kbeckmann/Glasgow/hardware/boards/glasgow/glasgow.kicad_pcb

## KiCad design hardware/boards/glasgow/glasgow.kicad_pcb (2018-10-31)

Schematic: glasgow.sch, Base Board

Parts:
C1, C14, C16, C19, C26, C27, C28, C76, C80: 4u7; C_0603_1608Metric_Pad1.05x0.95mm_HandSolder; MPN LMK107BJ475KAHT
C2, C3, C4, C5, C6, C7, C8, C9, C10, C13, C15, C17, C18, C20, C21, C22, C23, C24, C25, C33, C77, C81: u1; C_0402_1005Metric; MPN TMK107BJ154KA-T
C11, C12: 18p; C_0402_1005Metric; MPN CC0603JRNPO8BN180
C78, C79: u1; C_0402_1005Metric; MPN LMK107BJ475KAHT
D1, D2, D3: GRN; LED_0603_1608Metric_Pad0.82x1.00mm_HandSolder; MPN 150060GS75000
D4: YEL; LED_0603_1608Metric_Pad0.82x1.00mm_HandSolder; MPN 150060YS75000
D5: RED; LED_0603_1608Metric_Pad0.82x1.00mm_HandSolder; MPN 150060RS75000
J1: USB_B_Micro; USB_Micro-B_Molex_47346-0001; MPN 47346-0001
J4: Conn_01x02; PinHeader_1x02_P2.54mm_Horizontal; MPN 22-05-3021
J5: Conn_02x22_Odd_Even; PinHeader_2x22_P1.27mm_Vertical_SMD
MK1, MK2, MK3, MK4: Mounting_Hole_PAD; MountingHole_3.2mm_M3_Pad
MK5, MK6: Mounting_Hole; MountingHole_2.5mm
R1, R2, R12, R13, R14: 2k2; R_0402_1005Metric; MPN RC0603FR-132K2L
R3: 1M; R_0402_1005Metric; MPN RC0603FR-131ML
R4, R6, R7, R8, R9, R17, R18, R19: 100k; R_0402_1005Metric; MPN RC0603FR-10100KL
R5: 220k; R_0402_1005Metric; MPN RC0603FR-10220KL
R10: 130; R_0402_1005Metric; MPN AC0603FR-07130RL
R15: 390; R_0402_1005Metric; MPN RC0603FR-13390RL
R16: 604; R_0402_1005Metric; MPN RC0603FR-07604RL
R31, R32: 100; R_0402_1005Metric; MPN RC0603FR-07100RL
TP1: 5V; TestPoint_Pad_D1.0mm
TP2: 1V2; TestPoint_Pad_D1.0mm
TP3, TP7: 3V3; TestPoint_Pad_D1.0mm
TP4: SDA; TestPoint_Pad_D1.0mm
TP5: SCL; TestPoint_Pad_D1.0mm
TP6: CLKREF; TestPoint_Pad_D1.0mm
U1: CY7C68013A-56LTX; Cypress_QFN-56-1EP_8x8mm_P0.5mm_EP6.22x6.22mm_ThermalVias; MPN CY7C68013A-56LTXC
U2: CAT24M01W; SOIC-8_3.9x4.9mm_P1.27mm; MPN CAT24M01WI-GT3
U3: CAT24C256W; SOIC-8_3.9x4.9mm_P1.27mm; MPN CAT24C256WI-GT3
U7: LM3880MF-1AF; SOT-23-6; MPN LM3880MFX-1AF/NOPB
U8: MIC5355-S4YMME; MSOP-8-1EP_3x3mm_P0.65mm_EP2.54x2.8mm_ThermalVias; MPN MIC5355-S4YMME
U15: TPD3S014; SOT-23-6; MPN TPD3S014DBVR
U30: ICE40HX8K-BG121; BGA-121_9.0x9.0mm_Layout11x11_P0.8mm_Ball0.4mm_Pad0.35mm_NS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
Y1: 24M; Crystal_SMD_3225-4pin_3.2x2.5mm; MPN LFXTAL058124REEL

Connections:
+1V2: C18.1, C24.1, C25.1, C27.1, C77.1, J5.6, R31.2, R32.2, TP2.1, U8.7, U30.D4, U30.D8, U30.H4, U30.H8
+3V3: C1.1, C2.1, C3.1, C4.1, C5.1, C6.1, C7.1, C9.1, C10.1, C14.1, C15.1, C16.1, C17.1, C19.1, C20.1, C21.1, C22.1, C23.1, C28.1, C81.1, J5.4, R1.2, R2.2, R4.2, R10.2, R12.1, R17.2, TP3.1, U1.3, U1.7, U1.11, U1.17, U1.27, U1.32, U1.43, U1.44, U1.55, U2.2, U2.8, U3.1 (A0), U3.8 (VCC), U8.8, U30.C10, U30.D6, U30.F8, U30.H6, U30.L11; also elsewhere on the board
+5V: C26.1, J5.2, R5.2, R7.2, R8.2, TP1.1, U7.1, U8.1, U15.4; also elsewhere on the board
/1V2EN: R8.1, U7.6, U8.4
/3V3EN: R7.1, U7.5, U8.5
/A0: U1.37, U30.K3
/A1: U1.38, U30.L2
/CLKIF: TP7.1, U1.13, U30.K6
/CLKREF: TP6.1, U1.54, U30.L5
/D0: U1.18, U30.H7
/D1: U1.19, U30.J7
/D2: U1.20, U30.J9
/D3: U1.21, U30.K10
/D4: U1.22, U30.L10
/D5: U1.23, U30.K9
/D6: U1.24, U30.L8
/D7: U1.25, U30.K7
/ENVA: R18.1, U1.45; also elsewhere on the board
/ENVB: R19.1, U1.51; also elsewhere on the board
/FLAGA: U1.29, U30.L7
/FLAGB: U1.30, U30.K5
/FLAGC: U1.31, U30.L4
/FLAGD: U1.40, U30.J3
/FPGA_DONE: U1.36, U30.K8
/GNDPLL0: C76.2, C78.2, U30.L6
/GNDPLL1: C79.2, C80.2, U30.C5
/LED_ACT: R15.1, U1.49
/LED_CY: R13.1, U1.47
/LED_ERR: R16.1, U1.50
/LED_FPGA: R14.1, U1.48
/OE: U1.35, U30.L3
/PGOOD: R5.1, R6.2, U7.3
/PKTEND: U1.39, U30.L1
/RD: U1.1, U30.J5
/SCL: R2.1, TP5.1, U1.15, U2.6, U3.6 (SCL); also elsewhere on the board
/SDA: R1.1, TP4.1, U1.16, U2.5, U3.5 (SDA); also elsewhere on the board
/SHLD: C13.1, J1.6, R3.1
/USB_N: J1.2, U1.9, U15.6
/USB_P: J1.3, U1.8, U15.5
/VCCPLL0: C76.1, C78.1, R31.1, U30.J6
/VCCPLL1: C79.1, C80.1, R32.1, U30.C6
/VIO_AUX: C33.1, J5.44, U30.E4, U30.G4
/VUSB: C8.1, J1.1, U15.1, U15.3
/WR: U1.2, U30.J4
/XTALIN: C12.1, U1.5, Y1.1
/XTALOUT: C11.1, U1.4, Y1.3
/Z0_N: J5.41, U30.B2
/Z0_P: J5.39, U30.B1
/Z1_N: J5.38, U30.C3
/Z1_P: J5.40, U30.C4
/Z2_N: J5.33, U30.C1
/Z2_P: J5.35, U30.C2
/Z3_N: J5.29, U30.D1
/Z3_P: J5.27, U30.E1
/Z4_N: J5.34, U30.D3
/Z4_P: J5.32, U30.D2
/Z5_N: J5.26, U30.E3
/Z5_P: J5.28, U30.E2
/Z6_N: J5.23, U30.F2
/Z6_P: J5.21, U30.F1
/Z7_N: J5.20, U30.F3
/Z7_P: J5.22, U30.F4
/Z8_N: J5.17, U30.G2
/Z8_P: J5.15, U30.G1
/Z9_N: J5.14, U30.H3
/Z9_P: J5.16, U30.G3
/Z10_N: J5.11, U30.H2
/Z10_P: J5.9, U30.H1
/Z11_N: J5.3, U30.K1
/Z11_P: J5.5, U30.J1
/Z12_N: J5.10, U30.J2
/Z12_P: J5.8, U30.K2
/~ALERT: R17.1, U1.33, U30.K4; also elsewhere on the board
/~CY_RESET: R4.1, U1.42, U7.4
/~FPGA_RESET: R9.2, U1.34, U30.L9
/~SYNC: J4.2, R10.1
GND: C1.2, C2.2, C3.2, C4.2, C5.2, C6.2, C7.2, C8.2, C9.2, C10.2, C11.2, C12.2, C13.2, C14.2, C15.2, C16.2, C17.2, C18.2, C19.2, C20.2, C21.2, C22.2, C23.2, C24.2, C25.2, C26.2, C27.2, C28.2, C33.2, C77.2, C81.2, D1.1, D2.1, D3.1, D4.1, D5.1, J1.5, J4.1, J5.1, J5.7, J5.12, J5.13, J5.18, J5.19, J5.24, J5.25, J5.30, J5.31, J5.36, J5.37, J5.42, J5.43, MK1.1, MK2.1, MK3.1, MK4.1, R3.2, R6.1, R9.1, R18.2, R19.2, U1.6, U1.10, U1.12, U1.14, U1.26, U1.28, U1.41, U1.53, U1.56, U1.57, U2.4, U3.4 (GND), U7.2, U8.2, U8.9, U15.2, U30.E5, U30.E6, U30.E7, U30.F5, U30.F6, U30.F7, U30.G5, U30.G6, U30.G7, U30.H5, Y1.2, Y1.4; also elsewhere on the board
unnamed: D1.2, R12.2
unnamed: D2.2, R13.2
unnamed: D3.2, R14.2
unnamed: D4.2, R15.2
unnamed: D5.2, R16.2

Notes on the sheet:
All at 30 mcd
0.3 mA
5 mA
3 mA
Stencil alignment
Turn on at VBUS >4.5V
Addr: 101001X
Addr: 1010001
500 mA @ 1V2 500 mA @ 3V3
Addr DAC: 0001100 Addr ADC: 1010100
Addr DAC: 0001101 Addr ADC: 1010101
FPGA reset asserted on tristate
Imax @ 3V3 = 5 mA
Imax @ 3V3 = 3 mA
Imax(USB) @ 3V3 = 80 mA Imax @ 3V3 = 209 mA
Imax @ 3V3 = 38 mA (A+B) Imax @ 5V = 150 mA (A+B)
Addr: 0001000
FX2_MEM
ICE_MEM

Schematic: io_buffer.sch, I/O Buffer

Parts:
C29, C34, C39: 4u7; C_0603_1608Metric_Pad1.05x0.95mm_HandSolder; MPN LMK107BJ475KAHT
C30, C32, C35, C36, C38, C40, C47, C48, C49, C50, C51, C52, C53, C54, C55, C56, C57, C58, C59: u1; C_0402_1005Metric; MPN TMK107BJ154KA-T
C37: 12n; C_0402_1005Metric; MPN CC0603KRX7R8BB123
J2: Conn_02x10_Odd_Even; PinHeader_2x10_P2.54mm_Vertical; MPN 87834-2019
R20, R21: 10k; R_0402_1005Metric; MPN RC0603FR-1010KL
R22: 49k9; R_0402_1005Metric; MPN RC0603FR-0749K9L
R23: 59k; R_0402_1005Metric; MPN RC0603FR-0759KL
R24: 24k3; R_0402_1005Metric; MPN AC0603FR-0724K3L
RN1, RN2: R_Pack08; R_Array_Convex_8x0602; MPN TBD
U5, U6, U16, U17, U18, U19, U20, U21: SN74LVC1T45DRL; SOT-563
U9: ADC081C021CIMM; MSOP-8_3x3mm_P0.65mm; MPN ADC081C021CIMM/NOPB
U10: DAC081C081CIMK; SOT-23-6; MPN DAC081C081CIMK/NOPB
U11: TPS73101DBV; SOT-23-5; MPN TPS73101DBVR

Connections:
+3V3: C29.1, C30.1, C34.1, C35.1, C36.1, U5.1, U9.5, U10.2; also elsewhere on the board
+5V: C38.1, U11.1 (IN); also elsewhere on the board
/ENVA: U11.3 (EN); also elsewhere on the board
/IOBufferA/ADRADC: U9.3
/IOBufferA/ADRDAC: U10.6
/IOBufferA/DIR0: U5.5
/IOBufferA/DIR1: U18.5
/IOBufferA/DIR2: U6.5
/IOBufferA/DIR3: U19.5
/IOBufferA/DIR4: U16.5
/IOBufferA/DIR5: U20.5
/IOBufferA/DIR6: U17.5
/IOBufferA/DIR7: U21.5
/IOBufferA/VEXT: C39.1, C48.1, C49.1, C50.1, C51.1, C56.1, C57.1, C58.1, C59.1, J2.2, R23.2, U5.6, U6.6, U11.5 (OUT), U16.6, U17.6, U18.6, U19.6, U20.6, U21.6
/IOBufferA/VFB: R22.2, R23.1, R24.2, U11.4 (FB)
/IOBufferA/VSAMP: C37.1, R20.1, R21.2, U9.4
/IOBufferA/VSENSE: J2.1, R20.2
/IOBufferA/Y0: RN2.1, U5.4
/IOBufferA/Y1: RN2.2, U18.4
/IOBufferA/Y2: RN2.3, U6.4
/IOBufferA/Y3: RN2.4, U19.4
/IOBufferA/Y4: RN2.5, U16.4
/IOBufferA/Y5: RN2.6, U20.4
/IOBufferA/Y6: RN2.7, U17.4
/IOBufferA/Y7: RN2.8, U21.4
/IOBufferA/Z0: J2.3, RN2.16
/IOBufferA/Z1: J2.5, RN2.15
/IOBufferA/Z2: J2.7, RN2.14
/IOBufferA/Z3: J2.9, RN2.13
/IOBufferA/Z4: J2.11, RN2.12
/IOBufferA/Z5: J2.13, RN2.11
/IOBufferA/Z6: J2.15, RN2.10
/IOBufferA/Z7: J2.17, RN2.9
/QA0: RN1.1
/QA1: RN1.2
/QA2: RN1.3
/QA3: RN1.4
/QA4: RN1.5
/QA5: RN1.6
/QA6: RN1.7
/QA7: RN1.8
/SCL: U9.1, U10.5; also elsewhere on the board
/SDA: U9.8, U10.4; also elsewhere on the board
/~ALERT: U9.2; also elsewhere on the board
GND: C29.2, C30.2, C32.2, C34.2, C35.2, C36.2, C37.2, C38.2, C39.2, C40.2, C47.2, C48.2, C49.2, C50.2, C51.2, C52.2, C53.2, C54.2, C55.2, C56.2, C57.2, C58.2, C59.2, J2.4, J2.6, J2.8, J2.10, J2.12, J2.14, J2.16, J2.18, J2.20, R21.1, R24.1, U5.2, U6.2, U9.6, U9.7, U10.3, U11.2 (GND), U16.2, U17.2, U18.2, U19.2, U20.2, U21.2; also elsewhere on the board
unnamed: C32.1, U6.1
unnamed: C40.1, U16.1
unnamed: C47.1, U17.1
unnamed: C52.1, U18.1
unnamed: C53.1, U19.1
unnamed: C54.1, U20.1
unnamed: C55.1, U21.1
unnamed: R22.1, U10.1
unnamed: RN1.9, U21.3
unnamed: RN1.10, U17.3
unnamed: RN1.11, U20.3
unnamed: RN1.12, U16.3
unnamed: RN1.13, U19.3
unnamed: RN1.14, U6.3
unnamed: RN1.15, U18.3
unnamed: RN1.16, U5.3

Parts of its further copies:
C31, C41, C46: 4u7; C_0603_1608Metric_Pad1.05x0.95mm_HandSolder; MPN LMK107BJ475KAHT
C42, C43, C45, C60, C61, C62, C63, C64, C65, C66, C67, C68, C69, C70, C71, C72, C73, C74, C75: u1; C_0402_1005Metric; MPN TMK107BJ154KA-T
C44: 12n; C_0402_1005Metric; MPN CC0603KRX7R8BB123
J3: Conn_02x10_Odd_Even; PinHeader_2x10_P2.54mm_Vertical; MPN 87834-2019
R25, R26: 10k; R_0402_1005Metric; MPN RC0603FR-1010KL
R27: 49k9; R_0402_1005Metric; MPN RC0603FR-0749K9L
R28: 59k; R_0402_1005Metric; MPN RC0603FR-0759KL
R29: 24k3; R_0402_1005Metric; MPN AC0603FR-0724K3L
RN3, RN4: R_Pack08; R_Array_Convex_8x0602; MPN TBD
U12: ADC081C021CIMM; MSOP-8_3x3mm_P0.65mm; MPN ADC081C021CIMM/NOPB
U13: DAC081C081CIMK; SOT-23-6; MPN DAC081C081CIMK/NOPB
U14: TPS73101DBV; SOT-23-5; MPN TPS73101DBVR
U22, U23, U24, U25, U26, U27, U28, U29: SN74LVC1T45DRL; SOT-563

Connections of its further copies:
+3V3: C31.1, C41.1, C42.1, C43.1, C60.1, U12.5, U13.2, U22.1; also elsewhere on the board
+5V: C45.1, U14.1 (IN); also elsewhere on the board
/ENVB: U14.3 (EN); also elsewhere on the board
/IOBufferB/DIR0: U22.5
/IOBufferB/DIR1: U26.5
/IOBufferB/DIR2: U23.5
/IOBufferB/DIR3: U27.5
/IOBufferB/DIR4: U24.5
/IOBufferB/DIR5: U28.5
/IOBufferB/DIR6: U25.5
/IOBufferB/DIR7: U29.5
/IOBufferB/VEXT: C46.1, C64.1, C65.1, C66.1, C67.1, C72.1, C73.1, C74.1, C75.1, J3.2, R28.2, U14.5 (OUT), U22.6, U23.6, U24.6, U25.6, U26.6, U27.6, U28.6, U29.6
/IOBufferB/VFB: R27.2, R28.1, R29.2, U14.4 (FB)
/IOBufferB/VSAMP: C44.1, R25.1, R26.2, U12.4
/IOBufferB/VSENSE: J3.1, R25.2
/IOBufferB/Y0: RN4.1, U22.4
/IOBufferB/Y1: RN4.2, U26.4
/IOBufferB/Y2: RN4.3, U23.4
/IOBufferB/Y3: RN4.4, U27.4
/IOBufferB/Y4: RN4.5, U24.4
/IOBufferB/Y5: RN4.6, U28.4
/IOBufferB/Y6: RN4.7, U25.4
/IOBufferB/Y7: RN4.8, U29.4
/IOBufferB/Z0: J3.3, RN4.16
/IOBufferB/Z1: J3.5, RN4.15
/IOBufferB/Z2: J3.7, RN4.14
/IOBufferB/Z3: J3.9, RN4.13
/IOBufferB/Z4: J3.11, RN4.12
/IOBufferB/Z5: J3.13, RN4.11
/IOBufferB/Z6: J3.15, RN4.10
/IOBufferB/Z7: J3.17, RN4.9
/QB0: RN3.1
/QB1: RN3.2
/QB2: RN3.3
/QB3: RN3.4
/QB4: RN3.5
/QB5: RN3.6
/QB6: RN3.7
/QB7: RN3.8
/SCL: U12.1, U13.5; also elsewhere on the board
/SDA: U12.8, U13.4; also elsewhere on the board
/~ALERT: U12.2; also elsewhere on the board
GND: C31.2, C41.2, C42.2, C43.2, C44.2, C45.2, C46.2, C60.2, C61.2, C62.2, C63.2, C64.2, C65.2, C66.2, C67.2, C68.2, C69.2, C70.2, C71.2, C72.2, C73.2, C74.2, C75.2, J3.4, J3.6, J3.8, J3.10, J3.12, J3.14, J3.16, J3.18, J3.20, R26.1, R29.1, U12.3, U12.6, U12.7, U13.3, U13.6, U14.2 (GND), U22.2, U23.2, U24.2, U25.2, U26.2, U27.2, U28.2, U29.2; also elsewhere on the board
unnamed: C61.1, U23.1
unnamed: C62.1, U24.1
unnamed: C63.1, U25.1
unnamed: C68.1, U26.1
unnamed: C69.1, U27.1
unnamed: C70.1, U28.1
unnamed: C71.1, U29.1
unnamed: R27.1, U13.1
unnamed: RN3.9, U29.3
unnamed: RN3.10, U25.3
unnamed: RN3.11, U28.3
unnamed: RN3.12, U24.3
unnamed: RN3.13, U27.3
unnamed: RN3.14, U23.3
unnamed: RN3.15, U26.3
unnamed: RN3.16, U22.3

Notes on the sheet:
Addr (ADR=X): 0001100 Addr (ADR=L): 0001101 Addr (ADR=H): 0001110
Addr (ADR=X): 1010100 Addr (ADR=L): 1010101 Addr (ADR=H): 1010110
Csamp = 20 pF Bits = 8 Cext = (2**(Bits+1)-1)*Csamp = 10.2 nF (min) Gamma = ln(2**(Bits+1)) = 6.24 Freq = 1 ksps Rsource = 1/(Gamma*Cext*Freq) = 15.7 kohm (max) Rdiv = 2*Rsource = 31.4 kohm (max)
Imax @ 3V3 = 0.16 mA
Imax @ 3V3 = 0.73 mA
Imax @ 5V = 150 mA
Imax @ 3V3 = 32 mA each Imax @ Vtg = 32 mA each
LDO Input Cap

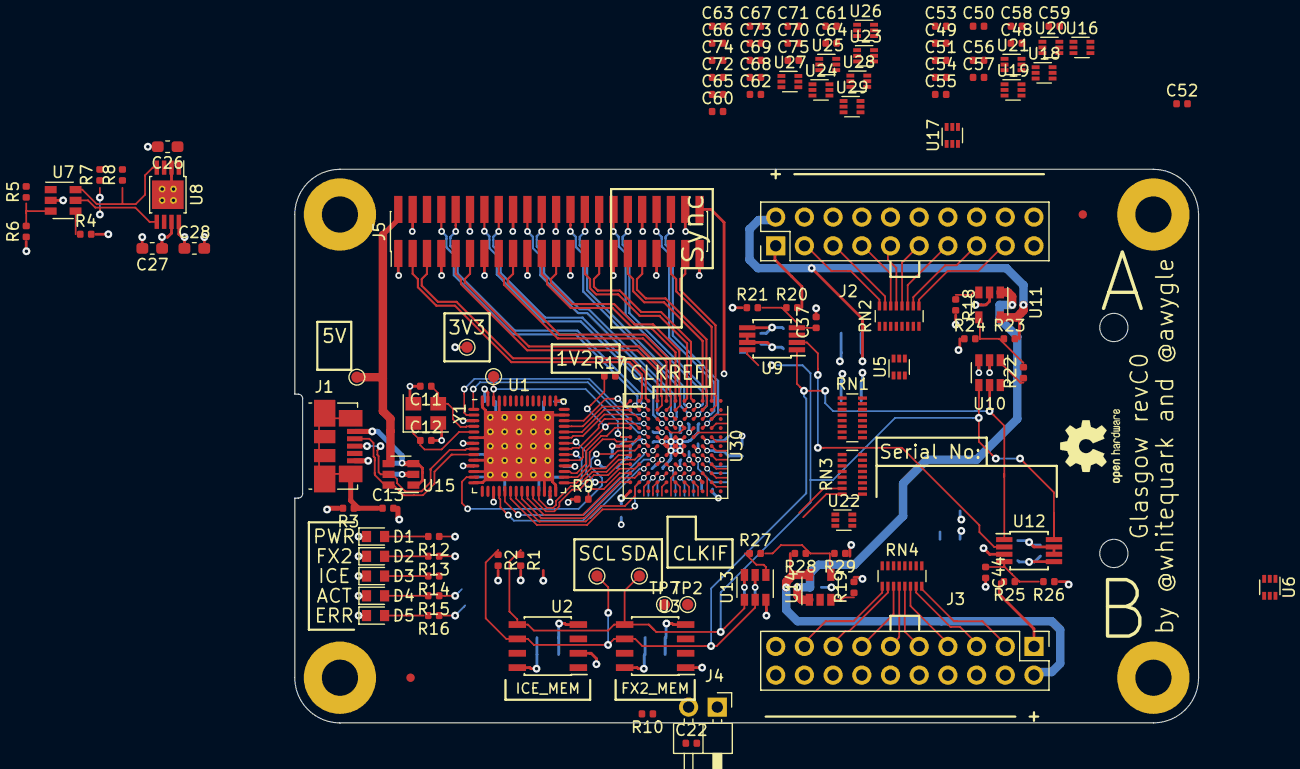
[picture p1: board glasgow.kicad_pcb from above]

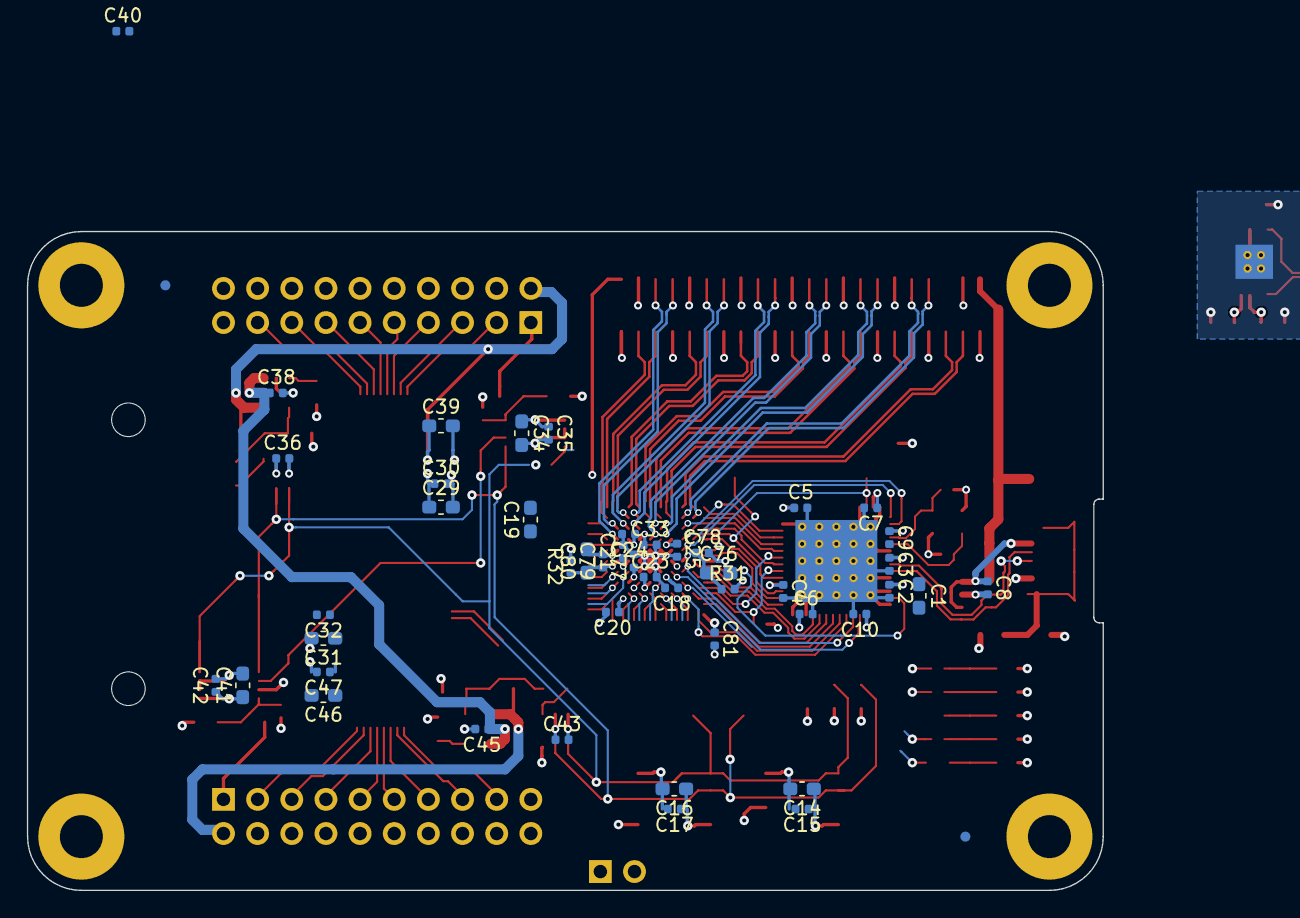
[picture p2: board glasgow.kicad_pcb from below]

Board: 4 copper layers, 80.0 x 49.0 mm, 172 parts (48 on the bottom side), 154 nets.

Other parts of the board:
FID1, FID1#2, FID2, FID4: Fiducial_0.75mm_Dia_1.5mm_Outer
