kbeckmann/Glasgow/(commit log)

2018-10-29 Initial Rev C IO cell schematic.
2018-10-29 Add modified SOT-563 footprint
2018-10-29 revC WIP PCB work
    [glasgow.kicad_pcb, glasgow.sch, io_buffer.sch]
2018-10-31 revC: FX2<->FPGA routing take 1
    [glasgow.kicad_pcb, glasgow.sch, io_buffer.sch]
2018-10-31 revC: FX2<->FPGA routing take 2
    [glasgow.kicad_pcb]
2018-10-31 revC: delete old FPGA
    No useful information left, since it's mostly just the port routing
    remaining
    [glasgow.kicad_pcb, glasgow.sch]
2018-10-31 revC: route missing D0 and D1
    [glasgow.kicad_pcb, glasgow.sch, io_buffer.sch]
2018-10-31 revC: fix some misc DRC errors
    [glasgow.kicad_pcb]
2018-10-31 revC: Update SOT563 footprints to Glasgow version and more DRC fixes
    [glasgow.kicad_pcb, io_buffer.sch]
2018-10-31 revC: fix connector placement, LVDS connector testing
    [glasgow.kicad_pcb, glasgow.sch, io_buffer.sch]
2018-10-31 revC: route LVDS
    [glasgow.kicad_pcb, glasgow.sch, io_buffer.sch]
